duncmccl/ARMStrong/README.md

# ARMStrong
Microcontroller Learner board replacement for the BASYS MX3
