duncmccl/ARMStrong/GRBL/UDUINO-BOM.xlsx

Comment | Designator | Footprint | Manufacturer | Manufacturer Part Number
A000066 | A101 | Custom:ARDUINO_A000066 | Arduino | A000066
100n | C101, C102, C103, C104, C107, C108, C402, C502, C1202, C1302 | Capacitor_SMD:C_0805_2012Metric | Samsung Electro-Mechanics | CL21B104KCFNNNE
4u7 | C105, C106, C109, C401, C501 | Capacitor_SMD:C_0603_1608Metric | Samsung Electro-Mechanics | CL10A475KO8NNNC
10u | C201, C302, C601, C1201, C1301 | Capacitor_SMD:C_0603_1608Metric | Samsung Electro-Mechanics | CL10A106KP8NNNC
10n | C202, C301, C602 | Capacitor_SMD:C_0603_1608Metric | Samsung Electro-Mechanics | 0603B103K500NT
2u2 | C303 | Capacitor_SMD:C_0603_1608Metric | Samsung Electro-Mechanics | CL10A225KO8NNNC
1n | C403, C404, C503, C504 | Capacitor_SMD:C_0603_1608Metric | Samsung Electro-Mechanics | CL10B102KB8NNNC
22u | C1203, C1204, C1303, C1304 | Capacitor_SMD:C_0603_1608Metric | Samsung Electro-Mechanics | CL10A226MQ8NRNC
BAS70TW | D101 | Package_TO_SOT_SMD:SOT-363_SC-70-6 | Diodes Incorporated | BAS70TW
LTST-C190KRKT | D801, D802, D803, D804, D805, D806, D807, D808 | LEDC1608X35N | Lite-On | LTST-C190KRKT
AMC1602AR-B-Y6WFDY-SPI | DS1101 | Custom:AMC1602ARBY6WFDYSPI | Orient Display | AMC1602AR-B-Y6WFDY-SPI
Barrel_Jack | J101 | Connector_BarrelJack:BarrelJack_Horizontal | GlobTek, Inc. | G-1005B
Conn_01x02_Female | J102 | Connector_JST:JST_XH_B2B-XH-AM_1x02_P2.50mm_Vertical
PMOD1 | J103 | Connector_PinSocket_2.54mm:PinSocket_2x06_P2.54mm_Horizontal
Conn_01x03_Male | J104, J105 | Connector_PinHeader_2.54mm:PinHeader_1x03_P2.54mm_Vertical
Conn_01x04_Male | J106, J107 | Connector_PinHeader_2.54mm:PinHeader_1x04_P2.54mm_Vertical
Screw_Terminal_01x04 | J301 | TerminalBlock:TerminalBlock_bornier-4_P5.08mm
4u7 | L1201, L1301 | Inductor_SMD:L_1008_2520Metric | Samsung Electro-Mechanics | CIGW252010GL4R7MNE
LDQ-M516RI | LED901 | Custom:DIPS1524W50P254L5030H800Q12N | Lumex Opto/Components Inc. | 67-1449-ND
Speaker | LS401, LS501 | Custom:SPKR_AS01508MS-SC11-WP-R | PUI Audio, Inc. | AS01508MS-SC11-WP-R
CMM-4030D-261-I2S-TR | MK201, MK601 | Custom:MIC_CMM-4030D-261-I2S-TR | CUI Devices | CMM-4030D-261-I2S-TR
USB4105-GF-A | P1401 | Connector_USB:USB_C_Receptacle_Palconn_UTC16-G
SMMBT4403LT1G | Q901, Q902, Q903, Q904 | Package_TO_SOT_SMD:SOT-23 | onsemi | SMMBT4403LT1G
10k | R101, R701, R702, R703, R704, R705, R706, R707, R708, R1001, R1002, R1003, R1004, R1005 | Resistor_SMD:R_0603_1608Metric | UNI-ROYAL(Uniroyal Elec) | 0603WAF1002T5E
100 | R201, R601, R1101, R1102 | Resistor_SMD:R_0603_1608Metric | UNI-ROYAL(Uniroyal Elec) | 0603WAF1000T5E
220 | R801, R802, R803, R804, R805, R806, R807, R808, R905, R906, R907, R908, R909, R910, R911, R912 | Resistor_SMD:R_0603_1608Metric | UNI-ROYAL(Uniroyal Elec) | 0603WAF2200T5E
1k | R901, R902, R903, R904 | Resistor_SMD:R_0603_1608Metric | UNI-ROYAL(Uniroyal Elec) | 0603WAF1001T5E
5k1 | R1401, R1402 | Resistor_SMD:R_0603_1608Metric | UNI-ROYAL(Uniroyal Elec) | 0603WAF5101T5E
100k | RV101, RV1101 | Custom:TRIM_3352T-1-104LF | Bourns Inc. | 3352T-1-104LF
PTS636 SM43 SMTR LFS | S101, S102, S1002, S1003, S1004, S1005 | PTS636SM43SMTRLFS | C & K COMPONENTS | PTS636 SM43 SMTR LFS
EG1218 | S701, S702, S703, S704, S705, S706, S707, S708 | EG1218 | E-Switch | EG1218
PTS636_SM43_SMTR_LFS | S1001 | Custom:PTS636SM43SMTRLFS | C & K COMPONENTS | PTS636 SM43 SMTR LFS
STM32F072VBTx | U101 | Package_QFP:LQFP-100_14x14mm_P0.5mm | STMicroelectronics | STM32F072VBT6
DRV8833RTY | U301 | Package_DFN_QFN:Texas_S-PWQFN-N16_EP2.1x2.1mm | Texas Instruments | DRV8833RTYT
NAU8315YG | U401, U501 | Custom:QFN50P400X400X80-21N | Nuvoton Technology Corporation | NAU8315YG
AP63205WU | U1201 | Package_TO_SOT_SMD:TSOT-23-6 | Diodes Incorporated | AP63205WU-7
AP63203WU | U1301 | Package_TO_SOT_SMD:TSOT-23-6 | Diodes Incorporated | AP63203WU-7
