duncmccl/ARMStrong/(threads)

Thread 2 (2023-04-21):

Seven Segment Display Voltage

duncmccl, 2023-04-21:
The Seven Segment Display is intended to be driven with 5v, however the microcontroller uses 3v logic signals. Therefore an alternate design is needed, possibly using a level shifting circuit.

Thread 3 (2023-04-21):

I2S and SPI conflict

duncmccl, 2023-04-21:
I2S1 and SPI1 conflict in the microcontroller hardware. Only one can be used at a time, while the other must be substituted with a software alternative.

A redesign would omit the I2S interfaces, and instead use the ADC and DAC to drive the audio circuits.

Thread 4 (2023-04-21):

Schottky Diode

duncmccl, 2023-04-21:
At high current draw, the Schottky diode has a high resistance, dropping the output voltage by as much as two volts. An alternate part is needed.

Thread 5 (2023-04-21):

Serial Wire Debug pins mapping

duncmccl, 2023-04-21:
The Serial Wire Debug (SWD) pins are mapped to the same pins as the Motor controller. This makes it inconvenient to use the ST-Link device. The SWD pins should be remapped to the PMOD pins, or to debug dedicated pins.

Thread 6 (2023-04-21):

Power Regulators

duncmccl, 2023-04-21:
Current power regulators are buck converters that can drop the voltage to an appropriate level, however they are unable to boost it to needed levels. Need to pick a different part that can do so.
