duncmccl/ARMStrong/SevenSeg/LDQ-M516RI.pdf

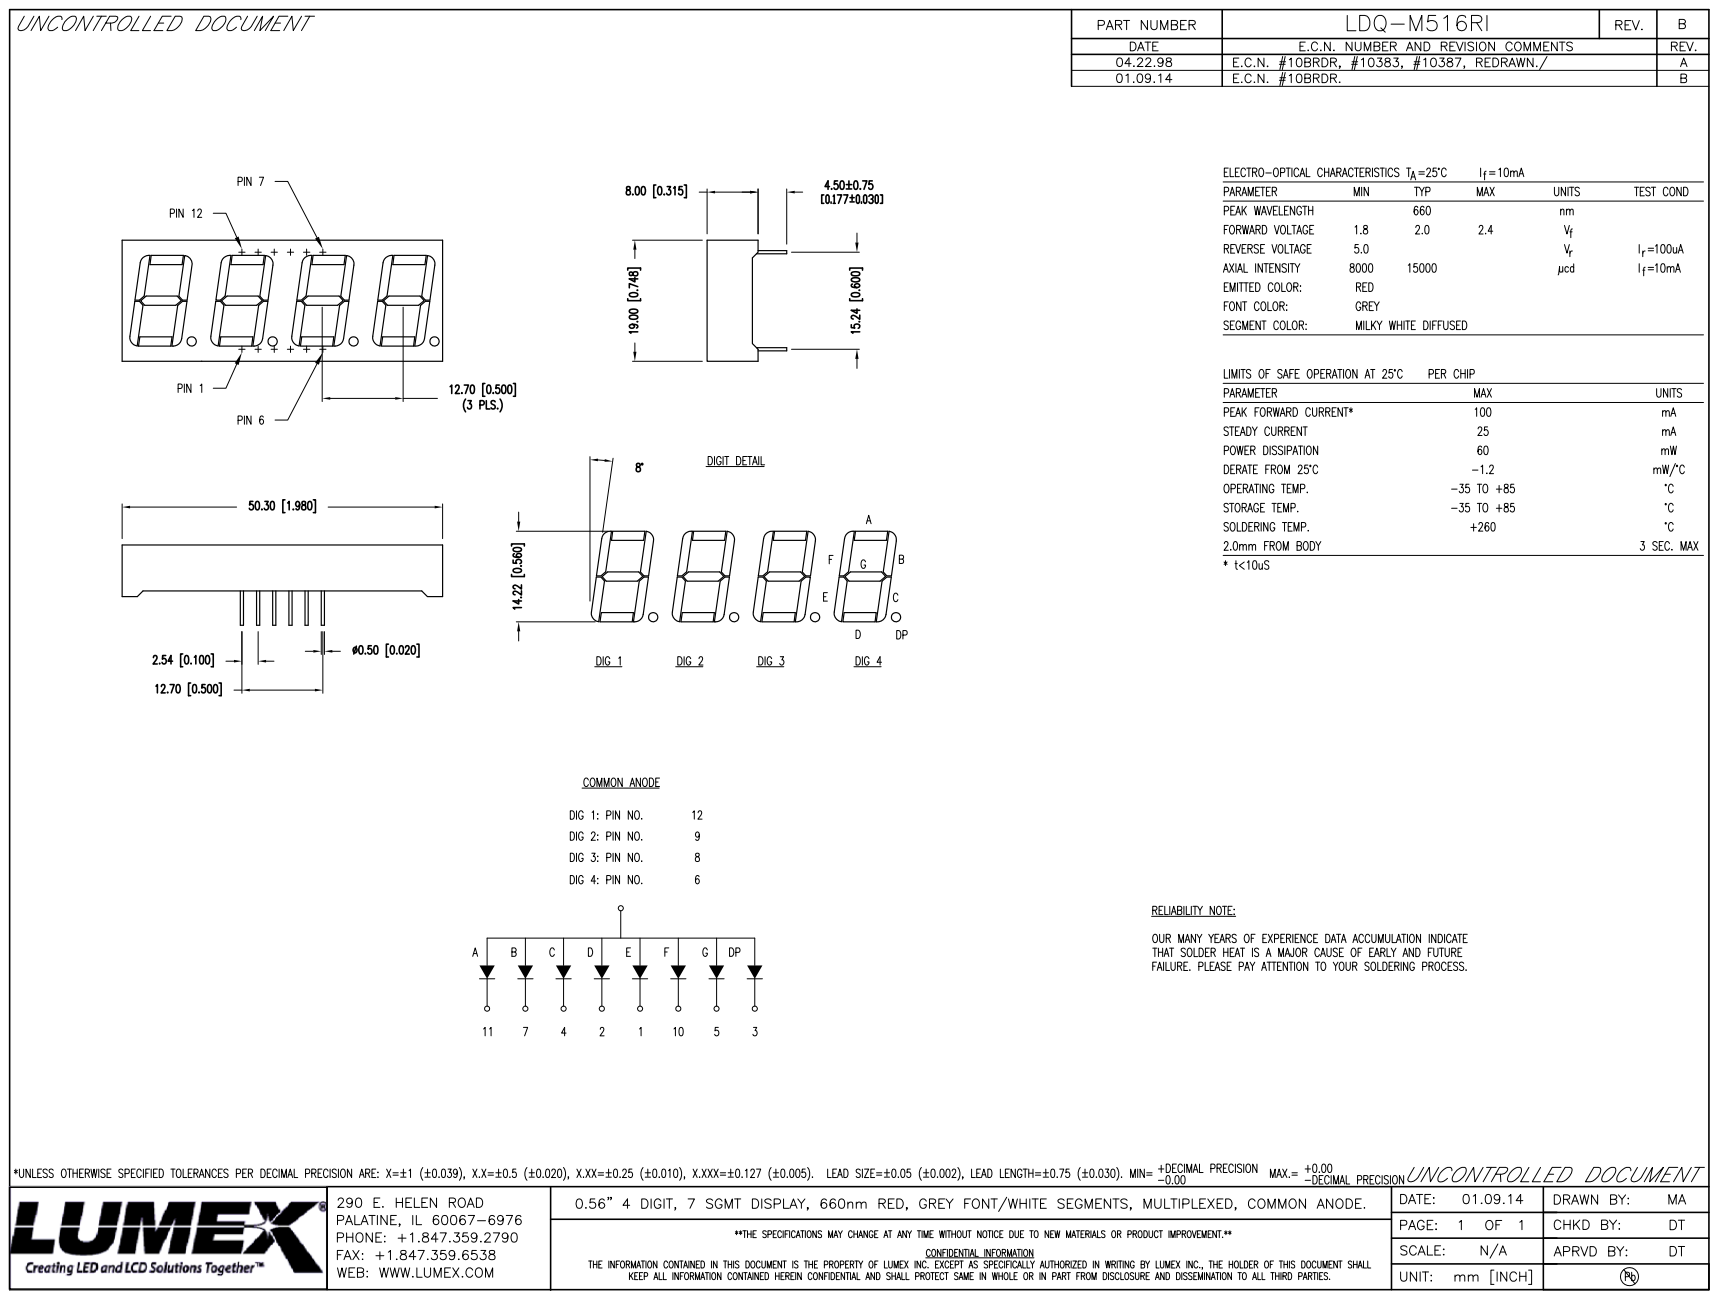
[picture p1: page 1]
