duncmccl/ARMStrong/UDuino.kicad_pcb

## KiCad design UDuino.kicad_pcb (2023-02-20)

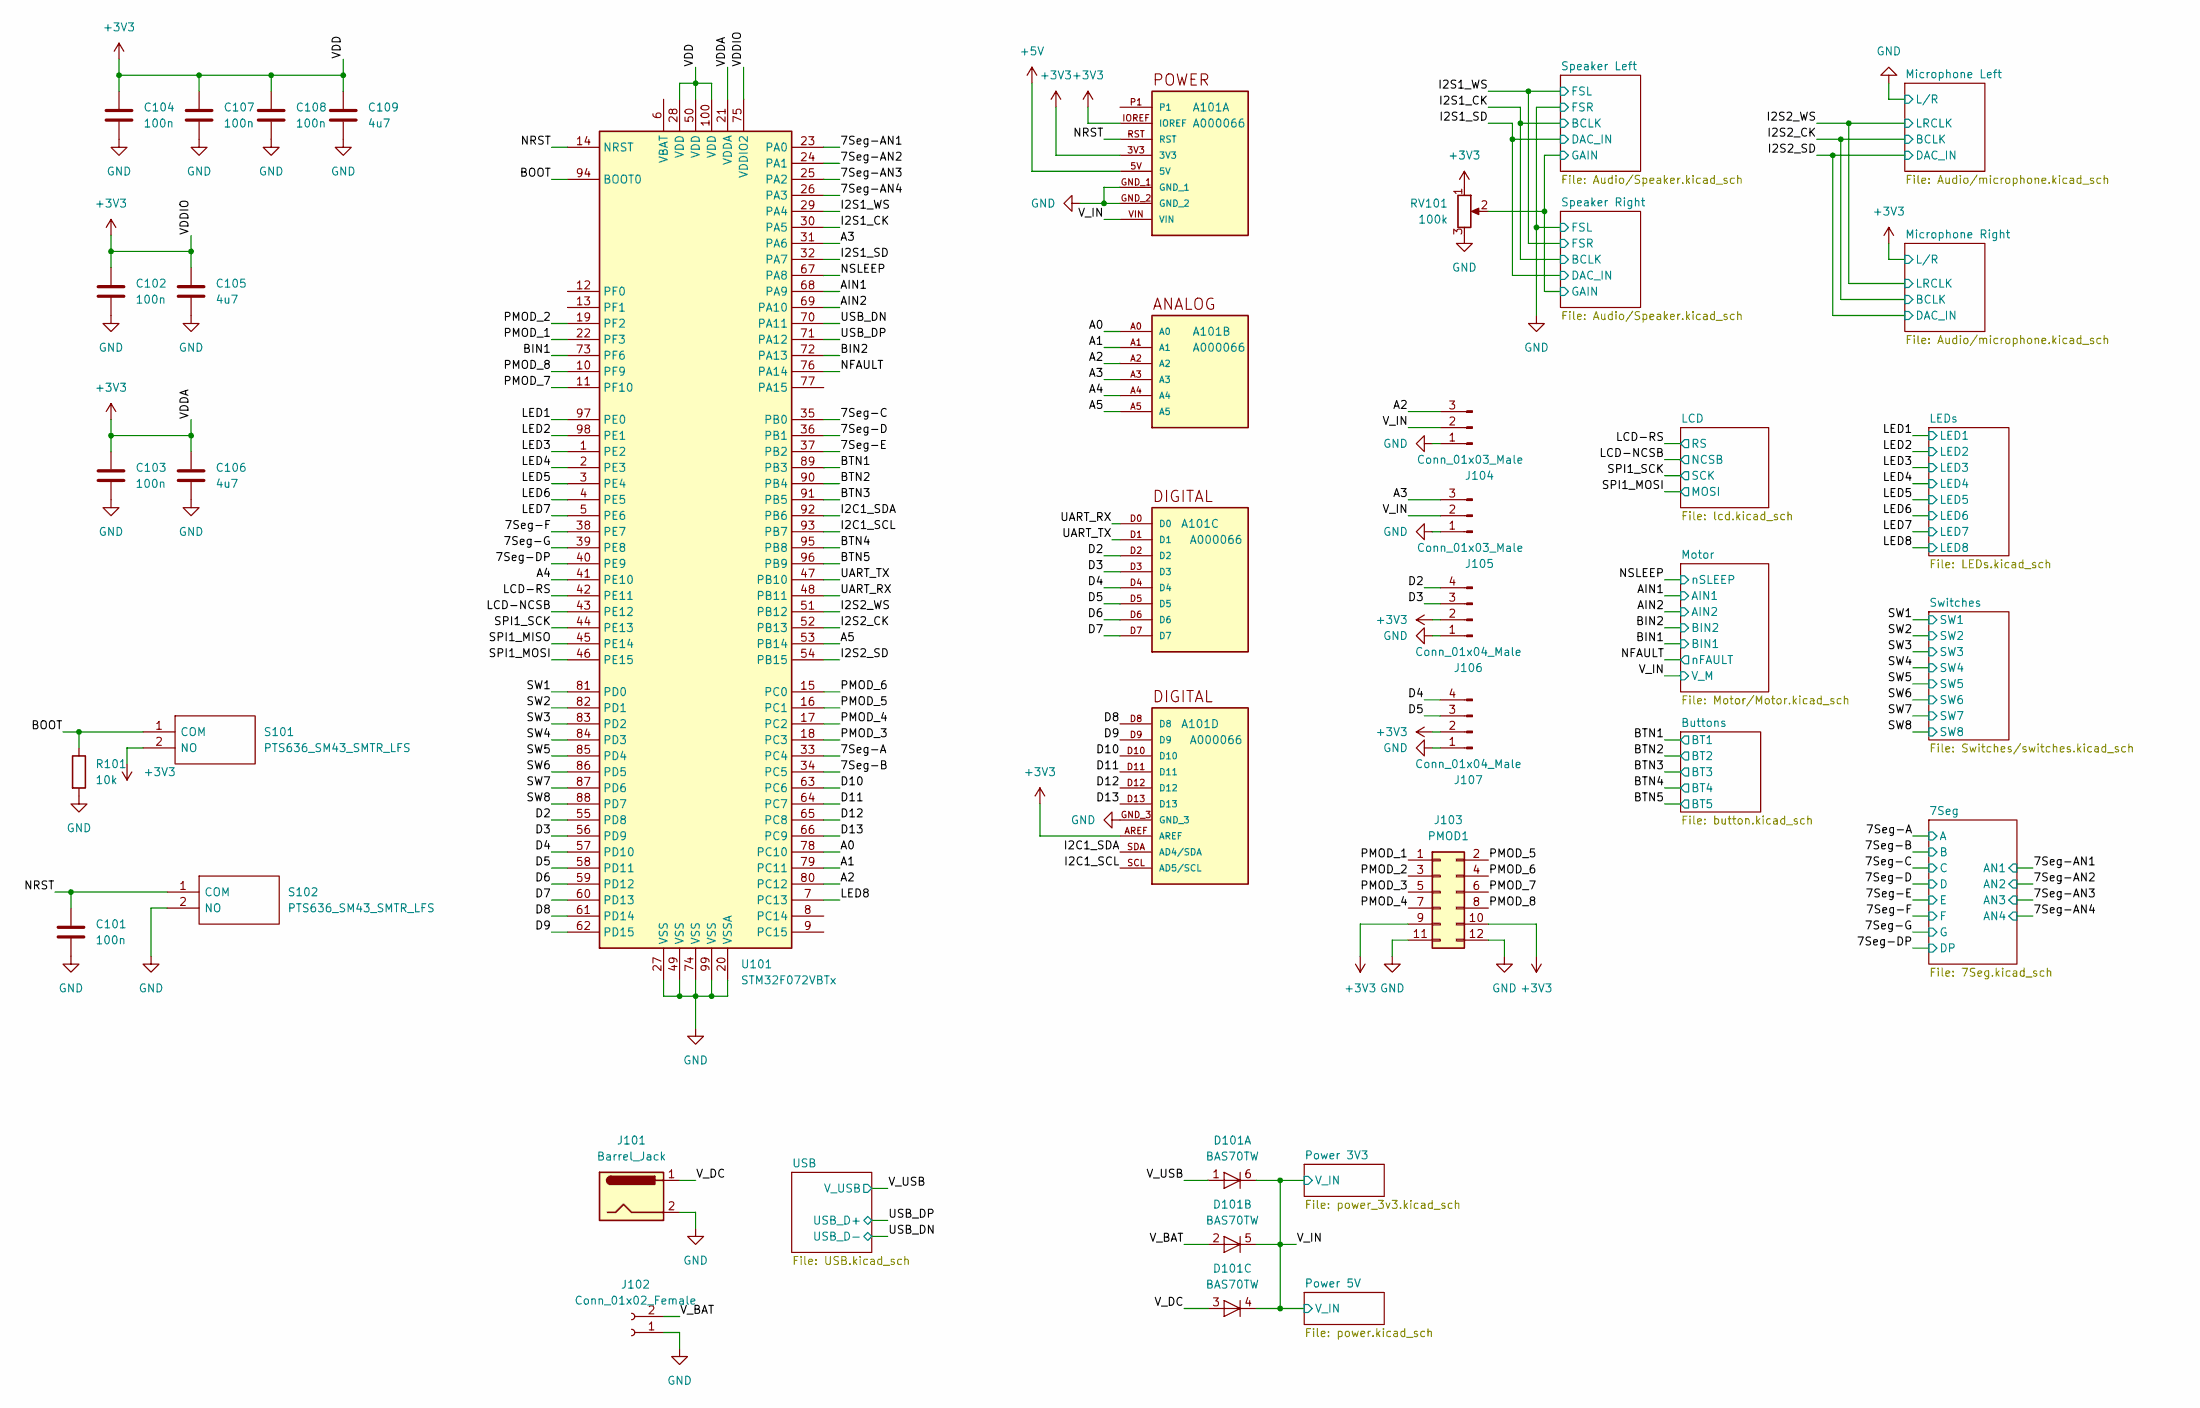
[picture p2: schematic UDuino.kicad_sch]

Parts:
A101: A000066; ARDUINO_A000066; Manufacturer_Part_Number A000066
C101, C102, C103, C104, C107, C108: 100n; C_0805_2012Metric; Manufacturer_Part_Number CL21B104KCFNNNE
C105, C106, C109: 4u7; C_0603_1608Metric; Manufacturer_Part_Number CL10A475KO8NNNC
D101: BAS70TW; SOT-363_SC-70-6; Manufacturer_Part_Number BAS70TW
J101: Barrel_Jack; BarrelJack_Horizontal; Manufacturer_Part_Number G-1005B
J102: Conn_01x02_Female; JST_XH_B2B-XH-AM_1x02_P2.50mm_Vertical
J103: PMOD1; PinSocket_2x06_P2.54mm_Horizontal
J104, J105: Conn_01x03_Male; PinHeader_1x03_P2.54mm_Vertical
J106, J107: Conn_01x04_Male; PinHeader_1x04_P2.54mm_Vertical
R101: 10k; R_0603_1608Metric; Manufacturer_Part_Number 0603WAF1002T5E
RV101: 100k; TRIM_3352T-1-104LF
S101, S102: PTS636_SM43_SMTR_LFS; PTS636SM43SMTRLFS; Mouser Part Number 611-PTS636SM43SMTRLF
U101: STM32F072VBTx; LQFP-100_14x14mm_P0.5mm

Connections:
+3V3: A101.3V3, A101.AREF, A101.IOREF, C102.2, C103.2, C104.2, C105.2, C106.2, C107.2, C108.2, C109.2, J103.9, J103.10, J106.2, J107.2, RV101.1, S101.2 (NO), U101.21 (VDDA), U101.28 (VDD), U101.50 (VDD), U101.75 (VDDIO2), U101.100 (VDD); also elsewhere on the board
+5V: A101.5V; also elsewhere on the board
/7Seg-A: U101.33 (PC4); also elsewhere on the board
/7Seg-AN1: U101.23 (PA0); also elsewhere on the board
/7Seg-AN2: U101.24 (PA1); also elsewhere on the board
/7Seg-AN3: U101.25 (PA2); also elsewhere on the board
/7Seg-AN4: U101.26 (PA3); also elsewhere on the board
/7Seg-B: U101.34 (PC5); also elsewhere on the board
/7Seg-C: U101.35 (PB0); also elsewhere on the board
/7Seg-D: U101.36 (PB1); also elsewhere on the board
/7Seg-DP: U101.40 (PE9); also elsewhere on the board
/7Seg-E: U101.37 (PB2); also elsewhere on the board
/7Seg-F: U101.38 (PE7); also elsewhere on the board
/7Seg-G: U101.39 (PE8); also elsewhere on the board
/A0: A101.A0, U101.78 (PC10)
/A1: A101.A1, U101.79 (PC11)
/A2: A101.A2, J104.3, U101.80 (PC12)
/A3: A101.A3, J105.3, U101.31 (PA6)
/A4: A101.A4, U101.41 (PE10)
/A5: A101.A5, U101.53 (PB14)
/AIN1: U101.68 (PA9); also elsewhere on the board
/AIN2: U101.69 (PA10); also elsewhere on the board
/BIN1: U101.73 (PF6); also elsewhere on the board
/BIN2: U101.72 (PA13); also elsewhere on the board
/BOOT: R101.1, S101.1 (COM), U101.94 (BOOT0)
/BTN1: U101.89 (PB3); also elsewhere on the board
/BTN2: U101.90 (PB4); also elsewhere on the board
/BTN3: U101.91 (PB5); also elsewhere on the board
/BTN4: U101.95 (PB8); also elsewhere on the board
/BTN5: U101.96 (PB9); also elsewhere on the board
/D2: A101.D2, J106.4, U101.55 (PD8)
/D3: A101.D3, J106.3, U101.56 (PD9)
/D4: A101.D4, J107.4, U101.57 (PD10)
/D5: A101.D5, J107.3, U101.58 (PD11)
/D6: A101.D6, U101.59 (PD12)
/D7: A101.D7, U101.60 (PD13)
/D8: A101.D8, U101.61 (PD14)
/D9: A101.D9, U101.62 (PD15)
/D10: A101.D10, U101.63 (PC6)
/D11: A101.D11, U101.64 (PC7)
/D12: A101.D12, U101.65 (PC8)
/D13: A101.D13, U101.66 (PC9)
/I2C1_SCL: A101.SCL (AD5/SCL), U101.93 (PB7)
/I2C1_SDA: A101.SDA (AD4/SDA), U101.92 (PB6)
/I2S1_CK: U101.30 (PA5); also elsewhere on the board
/I2S1_SD: U101.32 (PA7); also elsewhere on the board
/I2S1_WS: U101.29 (PA4); also elsewhere on the board
/I2S2_CK: U101.52 (PB13); also elsewhere on the board
/I2S2_SD: U101.54 (PB15); also elsewhere on the board
/I2S2_WS: U101.51 (PB12); also elsewhere on the board
/LCD-NCSB: U101.43 (PE12); also elsewhere on the board
/LCD-RS: U101.42 (PE11); also elsewhere on the board
/LED1: U101.97 (PE0); also elsewhere on the board
/LED2: U101.98 (PE1); also elsewhere on the board
/LED3: U101.1 (PE2); also elsewhere on the board
/LED4: U101.2 (PE3); also elsewhere on the board
/LED5: U101.3 (PE4); also elsewhere on the board
/LED6: U101.4 (PE5); also elsewhere on the board
/LED7: U101.5 (PE6); also elsewhere on the board
/LED8: U101.7 (PC13); also elsewhere on the board
/NFAULT: U101.76 (PA14); also elsewhere on the board
/NRST: A101.RST, C101.2, S102.1 (COM), U101.14 (NRST)
/NSLEEP: U101.67 (PA8); also elsewhere on the board
/PMOD_1: J103.1, U101.22 (PF3)
/PMOD_2: J103.3, U101.19 (PF2)
/PMOD_3: J103.5, U101.18 (PC3)
/PMOD_4: J103.7, U101.17 (PC2)
/PMOD_5: J103.2, U101.16 (PC1)
/PMOD_6: J103.4, U101.15 (PC0)
/PMOD_7: J103.6, U101.11 (PF10)
/PMOD_8: J103.8, U101.10 (PF9)
/SPI1_MISO: U101.45 (PE14)
/SPI1_MOSI: U101.46 (PE15); also elsewhere on the board
/SPI1_SCK: U101.44 (PE13); also elsewhere on the board
/SW1: U101.81 (PD0); also elsewhere on the board
/SW2: U101.82 (PD1); also elsewhere on the board
/SW3: U101.83 (PD2); also elsewhere on the board
/SW4: U101.84 (PD3); also elsewhere on the board
/SW5: U101.85 (PD4); also elsewhere on the board
/SW6: U101.86 (PD5); also elsewhere on the board
/SW7: U101.87 (PD6); also elsewhere on the board
/SW8: U101.88 (PD7); also elsewhere on the board
/Speaker Left/GAIN: RV101.2; also elsewhere on the board
/UART_RX: A101.D0, U101.48 (PB11)
/UART_TX: A101.D1, U101.47 (PB10)
/USB_DN: U101.70 (PA11); also elsewhere on the board
/USB_DP: U101.71 (PA12); also elsewhere on the board
/V_BAT: D101.2 (A), J102.2
/V_DC: D101.3 (A), J101.1
/V_IN: A101.VIN, D101.4 (K), D101.5 (K), D101.6 (K), J104.2, J105.2; also elsewhere on the board
/V_USB: D101.1 (A); also elsewhere on the board
GND: A101.GND_1, A101.GND_2, A101.GND_3, C101.1, C102.1, C103.1, C104.1, C105.1, C106.1, C107.1, C108.1, C109.1, J101.2, J102.1, J103.11, J103.12, J104.1, J105.1, J106.1, J107.1, R101.2, RV101.3, S102.2 (NO), U101.20 (VSSA), U101.27 (VSS), U101.49 (VSS), U101.74 (VSS), U101.99 (VSS); also elsewhere on the board

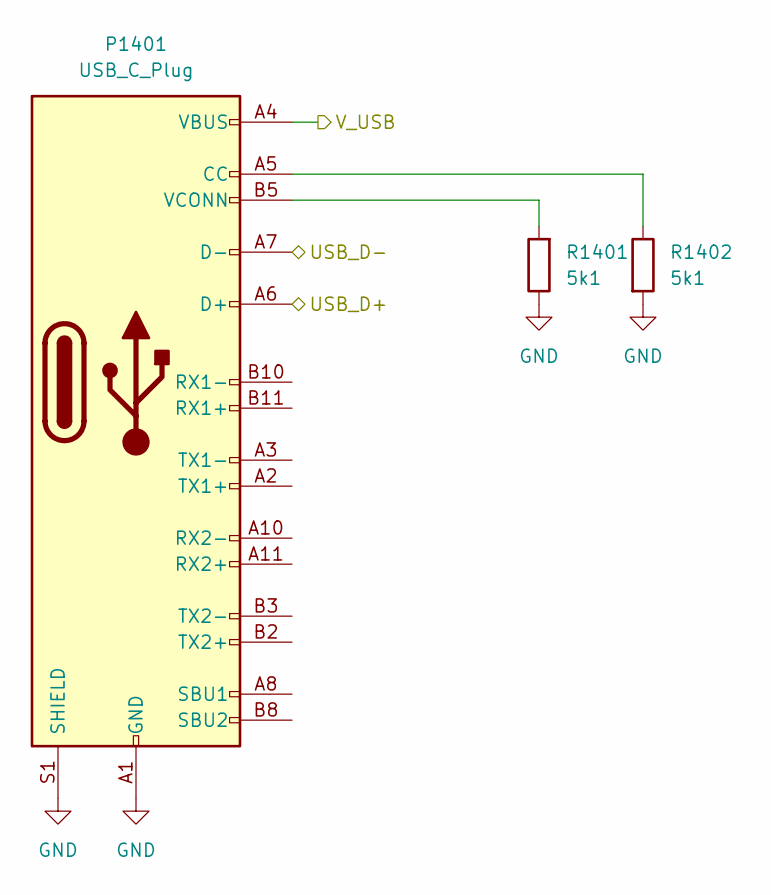
[picture p3: schematic USB.kicad_sch]

Parts:
P1401: USB_C_Plug; USB_C_Receptacle_Palconn_UTC16-G
R1401, R1402: 5k1; R_0603_1608Metric; Manufacturer_Part_Number 0603WAF5101T5E

Connections:
/USB_DN: P1401.A7 (D-); also elsewhere on the board
/USB_DP: P1401.A6 (D+); also elsewhere on the board
/V_USB: P1401.A4 (VBUS), P1401.A9 (VBUS), P1401.B4 (VBUS), P1401.B9 (VBUS); also elsewhere on the board
GND: P1401.A1 (GND), P1401.A12 (GND), P1401.B1 (GND), P1401.B12 (GND), P1401.S1 (SHIELD), R1401.1, R1402.2; also elsewhere on the board
unnamed: P1401.A5 (CC), R1402.1
unnamed: P1401.B5 (VCONN), R1401.2

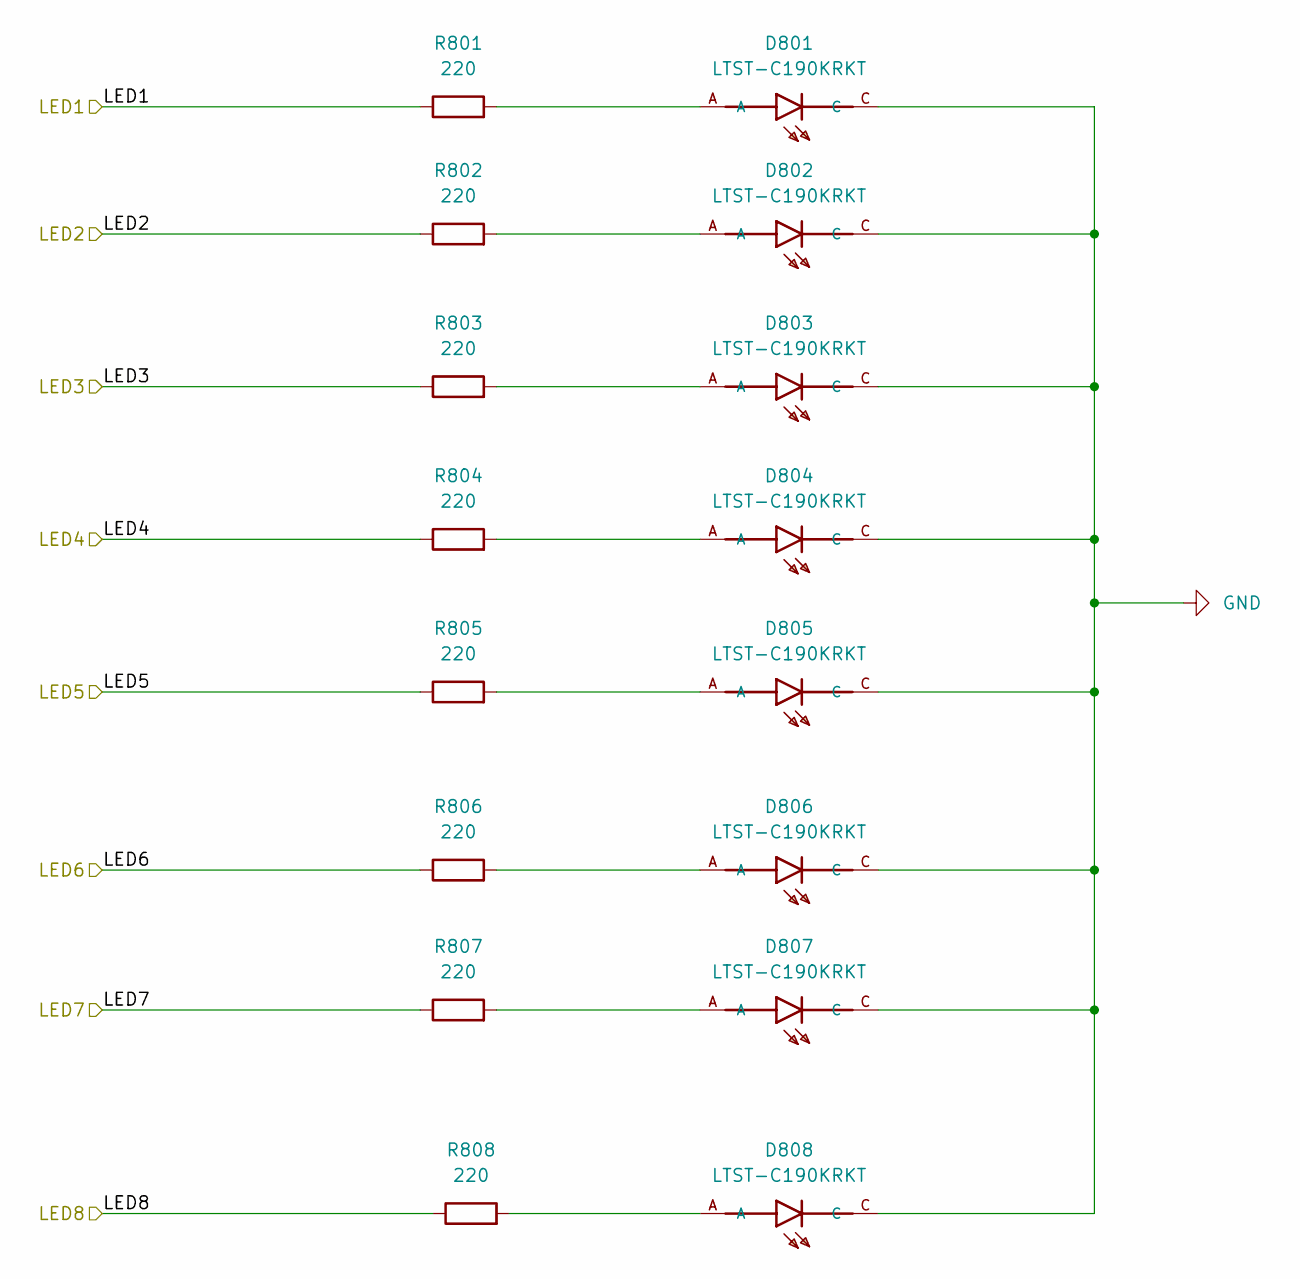
[picture p4: schematic LEDs.kicad_sch]

Parts:
D801, D802, D803, D804, D805, D806, D807, D808: LTST-C190KRKT; LEDC1608X35N; Manufacturer_Part_Number LTST-C190KRKT
R801, R802, R803, R804, R805, R806, R807, R808: 220; R_0603_1608Metric; Manufacturer_Part_Number 0603WAF2200T5E

Connections:
/LED1: R801.1; also elsewhere on the board
/LED2: R802.1; also elsewhere on the board
/LED3: R803.1; also elsewhere on the board
/LED4: R804.1; also elsewhere on the board
/LED5: R805.1; also elsewhere on the board
/LED6: R806.1; also elsewhere on the board
/LED7: R807.1; also elsewhere on the board
/LED8: R808.1; also elsewhere on the board
GND: D801.C, D802.C, D803.C, D804.C, D805.C, D806.C, D807.C, D808.C; also elsewhere on the board
unnamed: D801.A, R801.2
unnamed: D802.A, R802.2
unnamed: D803.A, R803.2
unnamed: D804.A, R804.2
unnamed: D805.A, R805.2
unnamed: D806.A, R806.2
unnamed: D807.A, R807.2
unnamed: D808.A, R808.2

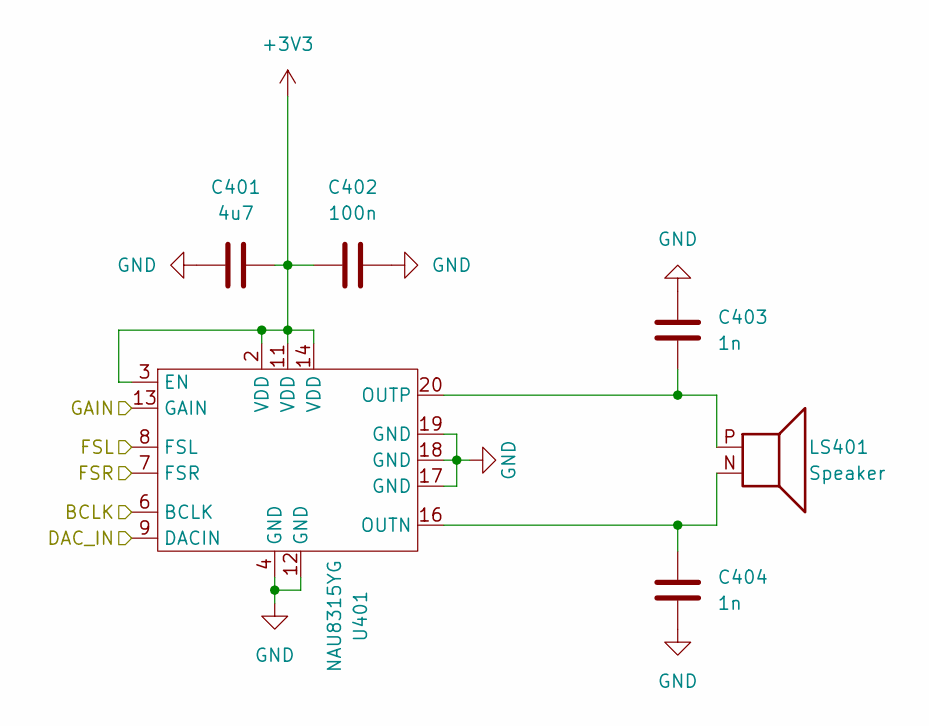
[picture p5: schematic Speaker.kicad_sch]

Parts:
C401: 4u7; C_0603_1608Metric; Manufacturer_Part_Number CL10A475KO8NNNC
C402: 100n; C_0805_2012Metric; Manufacturer_Part_Number CL21B104KCFNNNE
C403, C404: 1n; C_0603_1608Metric; Manufacturer_Part_Number CL10B102KB8NNNC
LS401: Speaker; SPKR_AS01508MS-SC11-WP-R
U401: NAU8315YG; QFN50P400X400X80-21N

Connections:
+3V3: C401.2, C402.1, U401.2 (VDD), U401.3 (EN), U401.11 (VDD), U401.14 (VDD); also elsewhere on the board
/I2S1_CK: U401.6 (BCLK); also elsewhere on the board
/I2S1_SD: U401.9 (DACIN); also elsewhere on the board
/I2S1_WS: U401.8 (FSL); also elsewhere on the board
/Speaker Left/GAIN: U401.13 (GAIN); also elsewhere on the board
GND: C401.1, C402.2, C403.1, C404.2, U401.4 (GND), U401.7 (FSR), U401.12 (GND), U401.17 (GND), U401.18 (GND), U401.19 (GND); also elsewhere on the board
unnamed: C403.2, LS401.P (1), U401.20 (OUTP)
unnamed: C404.1, LS401.N (2), U401.16 (OUTN)

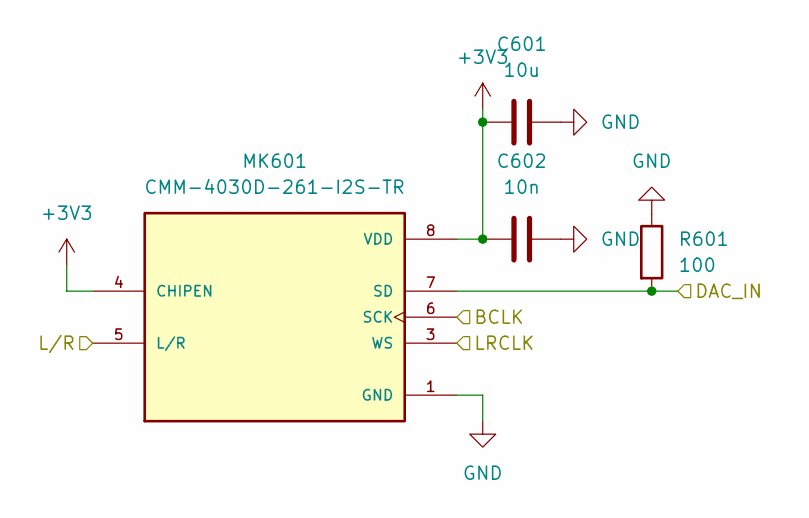
[picture p6: schematic microphone.kicad_sch]

Parts:
C601: 10u; C_0603_1608Metric; Manufacturer_Part_Number CL10A106KP8NNNC
C602: 10n; C_0603_1608Metric; Manufacturer_Part_Number 0603B103K500NT
MK601: CMM-4030D-261-I2S-TR; MIC_CMM-4030D-261-I2S-TR; PARTREV 1.0
R601: 100; R_0603_1608Metric; Manufacturer_Part_Number 0603WAF1000T5E

Connections:
+3V3: C601.1, C602.2, MK601.4 (CHIPEN), MK601.8 (VDD); also elsewhere on the board
/I2S2_CK: MK601.6 (SCK); also elsewhere on the board
/I2S2_SD: MK601.7 (SD), R601.2; also elsewhere on the board
/I2S2_WS: MK601.3 (WS); also elsewhere on the board
GND: C601.2, C602.1, MK601.1 (GND), MK601.5 (L/R), R601.1; also elsewhere on the board

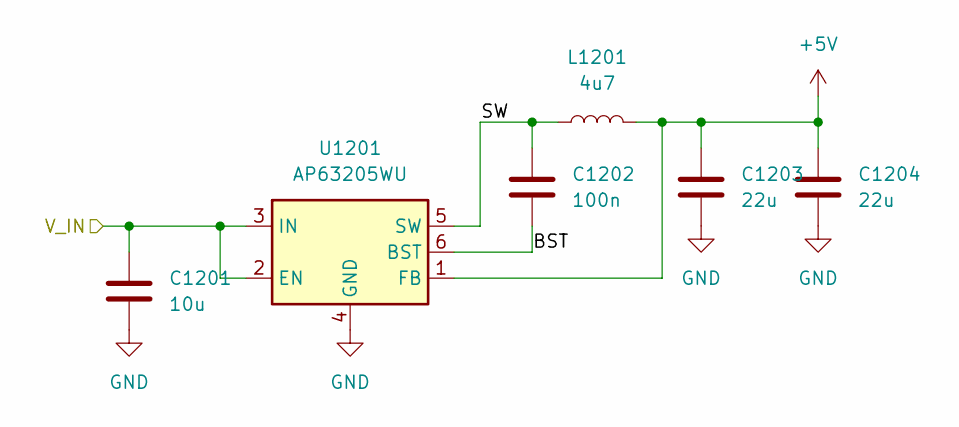
[picture p7: schematic power.kicad_sch]

Parts:
C1201: 10u; C_0603_1608Metric; Manufacturer_Part_Number CL10A106KP8NNNC
C1202: 100n; C_0805_2012Metric; Manufacturer_Part_Number CL21B104KCFNNNE
C1203, C1204: 22u; C_0603_1608Metric; Manufacturer_Part_Number CL10A226MQ8NRNC
L1201: 4u7; L_1008_2520Metric; Manufacturer_Part_Number CIGW252010GL4R7MNE
U1201: AP63205WU; TSOT-23-6

Connections:
+5V: C1203.1, C1204.1, L1201.2, U1201.1 (FB); also elsewhere on the board
/Power 5V/BST: C1202.2, U1201.6 (BST)
/Power 5V/SW: C1202.1, L1201.1, U1201.5 (SW)
/V_IN: C1201.1, U1201.2 (EN), U1201.3 (IN); also elsewhere on the board
GND: C1201.2, C1203.2, C1204.2, U1201.4 (GND); also elsewhere on the board

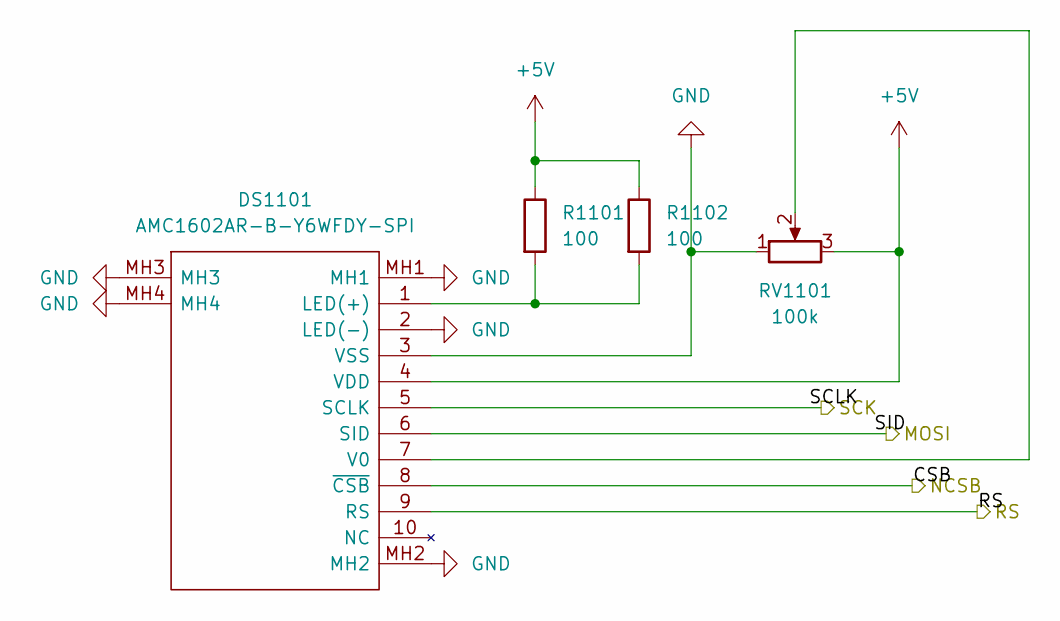
[picture p8: schematic lcd.kicad_sch]

Parts:
DS1101: AMC1602AR-B-Y6WFDY-SPI; AMC1602ARBY6WFDYSPI; Manufacturer_Part_Number AMC1602AR-B-Y6WFDY-SPI
R1101, R1102: 100; R_0603_1608Metric; Manufacturer_Part_Number 0603WAF1000T5E
RV1101: 100k; TRIM_3352T-1-104LF

Connections:
+5V: DS1101.4 (VDD), R1101.1, R1102.1, RV1101.3; also elsewhere on the board
/LCD-NCSB: DS1101.8 (~CSB); also elsewhere on the board
/LCD-RS: DS1101.9 (RS); also elsewhere on the board
/SPI1_MOSI: DS1101.6 (SID); also elsewhere on the board
/SPI1_SCK: DS1101.5 (SCLK); also elsewhere on the board
GND: DS1101.2 (LED(-)), DS1101.3 (VSS), DS1101.MH1, DS1101.MH2, DS1101.MH3, DS1101.MH4, RV1101.1; also elsewhere on the board
unnamed: DS1101.1 (LED(+)), R1101.2, R1102.2
unnamed: DS1101.7 (V0), RV1101.2

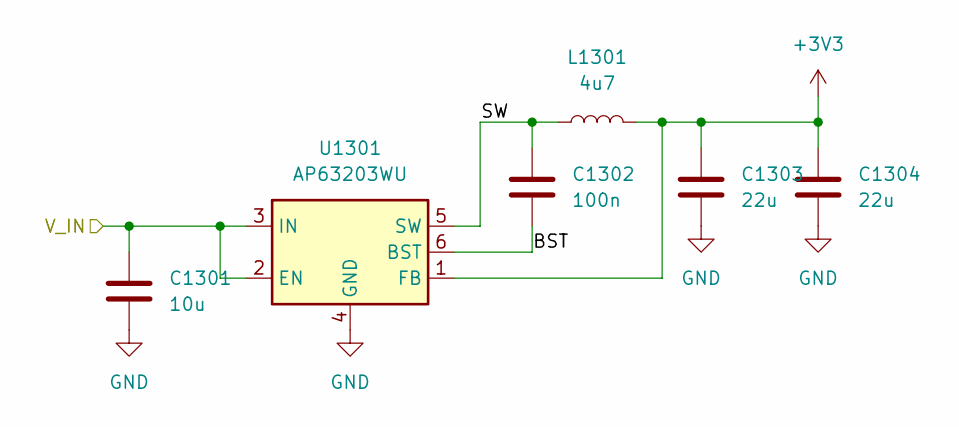
[picture p9: schematic power_3v3.kicad_sch]

Parts:
C1301: 10u; C_0603_1608Metric; Manufacturer_Part_Number CL10A106KP8NNNC
C1302: 100n; C_0805_2012Metric; Manufacturer_Part_Number CL21B104KCFNNNE
C1303, C1304: 22u; C_0603_1608Metric; Manufacturer_Part_Number CL10A226MQ8NRNC
L1301: 4u7; L_1008_2520Metric; Manufacturer_Part_Number CIGW252010GL4R7MNE
U1301: AP63203WU; TSOT-23-6

Connections:
+3V3: C1303.1, C1304.1, L1301.2, U1301.1 (FB); also elsewhere on the board
/Power 3V3/BST: C1302.2, U1301.6 (BST)
/Power 3V3/SW: C1302.1, L1301.1, U1301.5 (SW)
/V_IN: C1301.1, U1301.2 (EN), U1301.3 (IN); also elsewhere on the board
GND: C1301.2, C1303.2, C1304.2, U1301.4 (GND); also elsewhere on the board

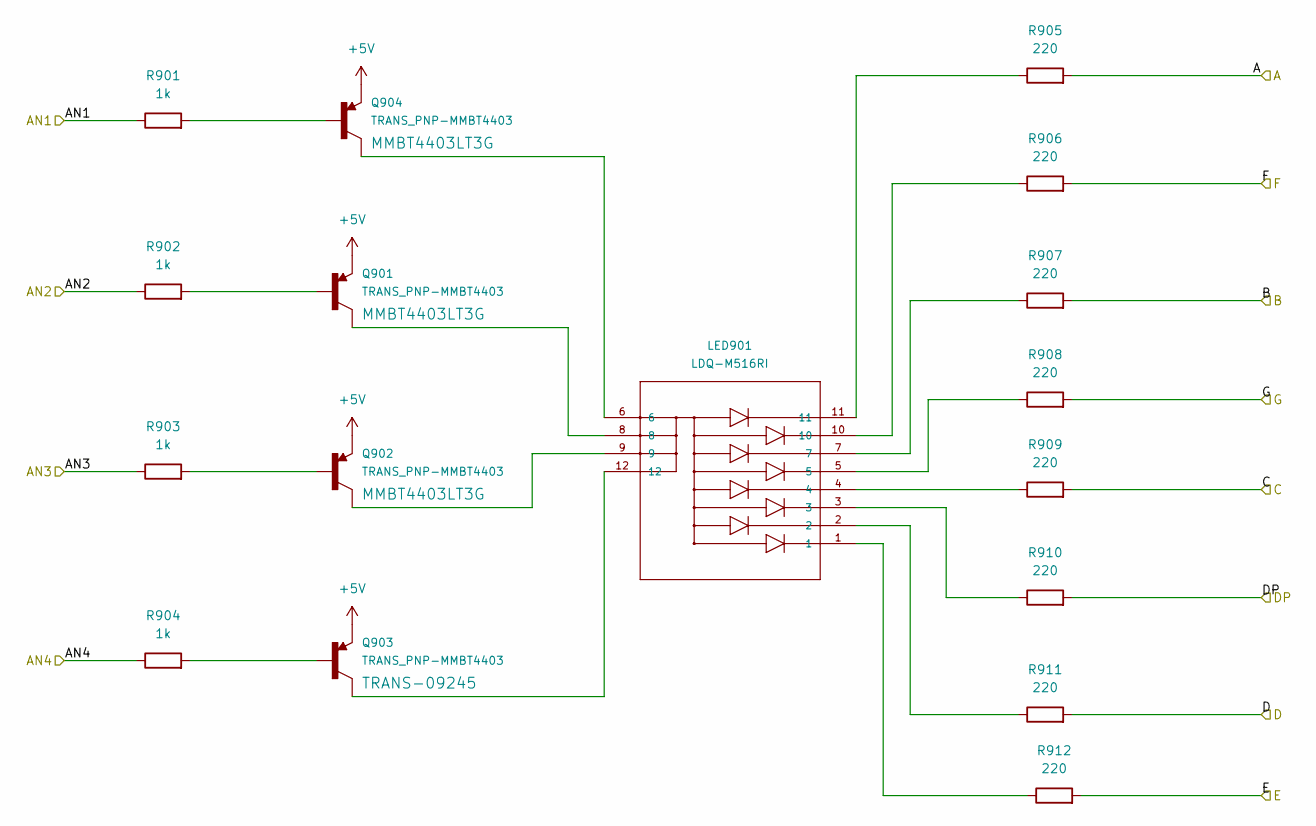
[picture p10: schematic 7Seg.kicad_sch]

Parts:
LED901: LDQ-M516RI; DIPS1524W50P254L5030H800Q12N
Q901, Q902, Q903, Q904: TRANS_PNP-MMBT4403; SOT-23
R901, R902, R903, R904: 1k; R_0603_1608Metric; Manufacturer_Part_Number 0603WAF1001T5E
R905, R906, R907, R908, R909, R910, R911, R912: 220; R_0603_1608Metric; Manufacturer_Part_Number 0603WAF2200T5E

Connections:
+5V: Q901.2 (E), Q902.2 (E), Q903.2 (E), Q904.2 (E); also elsewhere on the board
/7Seg-A: R905.2; also elsewhere on the board
/7Seg-AN1: R901.1; also elsewhere on the board
/7Seg-AN2: R902.1; also elsewhere on the board
/7Seg-AN3: R903.1; also elsewhere on the board
/7Seg-AN4: R904.1; also elsewhere on the board
/7Seg-B: R907.2; also elsewhere on the board
/7Seg-C: R909.2; also elsewhere on the board
/7Seg-D: R911.2; also elsewhere on the board
/7Seg-DP: R910.2; also elsewhere on the board
/7Seg-E: R912.2; also elsewhere on the board
/7Seg-F: R906.2; also elsewhere on the board
/7Seg-G: R908.2; also elsewhere on the board
unnamed: LED901.1, R912.1
unnamed: LED901.2, R911.1
unnamed: LED901.3, R910.1
unnamed: LED901.4, R909.1
unnamed: LED901.5, R908.1
unnamed: LED901.6, Q904.3 (C)
unnamed: LED901.7, R907.1
unnamed: LED901.8, Q901.3 (C)
unnamed: LED901.9, Q902.3 (C)
unnamed: LED901.10, R906.1
unnamed: LED901.11, R905.1
unnamed: LED901.12, Q903.3 (C)
unnamed: Q901.1 (B), R902.2
unnamed: Q902.1 (B), R903.2
unnamed: Q903.1 (B), R904.2
unnamed: Q904.1 (B), R901.2

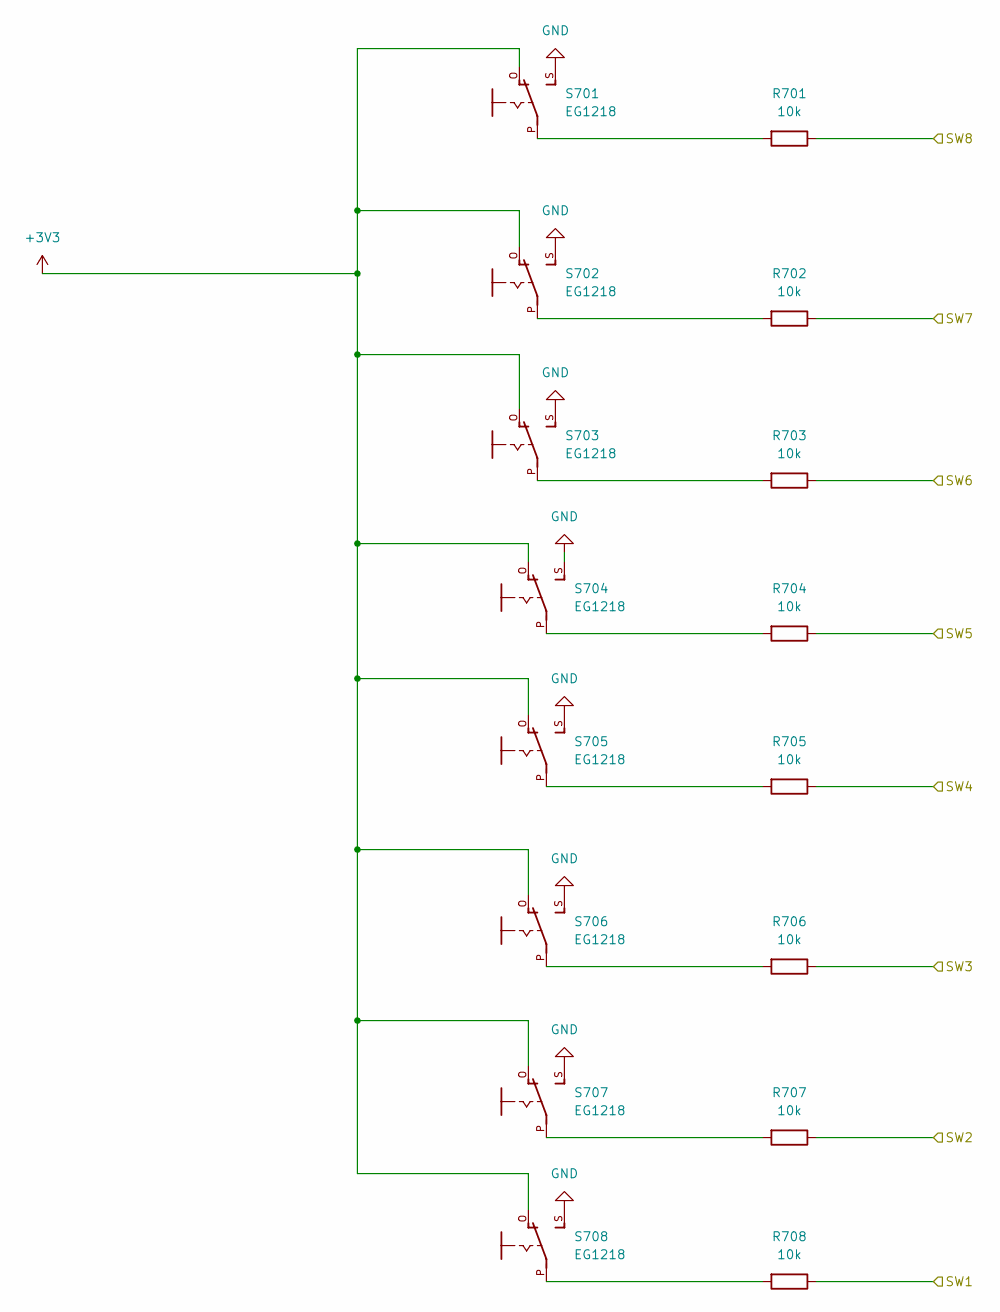
[picture p11: schematic switches.kicad_sch]

Parts:
R701, R702, R703, R704, R705, R706, R707, R708: 10k; R_0603_1608Metric; Manufacturer_Part_Number 0603WAF1002T5E
S701, S702, S703, S704, S705, S706, S707, S708: EG1218

Connections:
+3V3: S701.O, S702.O, S703.O, S704.O, S705.O, S706.O, S707.O, S708.O; also elsewhere on the board
/SW1: R708.1; also elsewhere on the board
/SW2: R707.1; also elsewhere on the board
/SW3: R706.1; also elsewhere on the board
/SW4: R705.1; also elsewhere on the board
/SW5: R704.1; also elsewhere on the board
/SW6: R703.1; also elsewhere on the board
/SW7: R702.1; also elsewhere on the board
/SW8: R701.1; also elsewhere on the board
GND: S701.S, S702.S, S703.S, S704.S, S705.S, S706.S, S707.S, S708.S; also elsewhere on the board
unnamed: R701.2, S701.P
unnamed: R702.2, S702.P
unnamed: R703.2, S703.P
unnamed: R704.2, S704.P
unnamed: R705.2, S705.P
unnamed: R706.2, S706.P
unnamed: R707.2, S707.P
unnamed: R708.2, S708.P

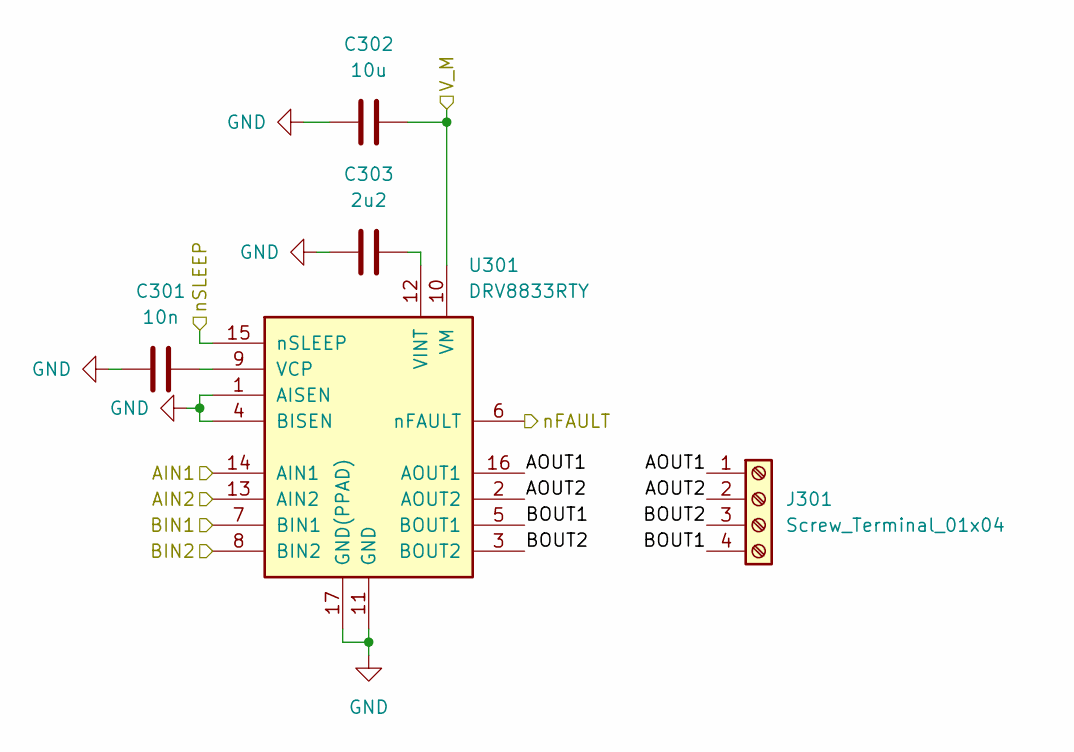
[picture p12: schematic Motor.kicad_sch]

Parts:
C301: 10n; C_0603_1608Metric; Manufacturer_Part_Number 0603B103K500NT
C302: 10u; C_0603_1608Metric; Manufacturer_Part_Number CL10A106KP8NNNC
C303: 2u2; C_0603_1608Metric; Manufacturer_Part_Number CL10A225KO8NNNC
J301: Screw_Terminal_01x04; TerminalBlock_bornier-4_P5.08mm
U301: DRV8833RTY; Texas_S-PWQFN-N16_EP2.1x2.1mm

Connections:
/AIN1: U301.14 (AIN1); also elsewhere on the board
/AIN2: U301.13 (AIN2); also elsewhere on the board
/BIN1: U301.7 (BIN1); also elsewhere on the board
/BIN2: U301.8 (BIN2); also elsewhere on the board
/Motor/AOUT1: J301.1, U301.16 (AOUT1)
/Motor/AOUT2: J301.2, U301.2 (AOUT2)
/Motor/BOUT1: J301.4, U301.5 (BOUT1)
/Motor/BOUT2: J301.3, U301.3 (BOUT2)
/NFAULT: U301.6 (nFAULT); also elsewhere on the board
/NSLEEP: U301.15 (nSLEEP); also elsewhere on the board
/V_IN: C302.2, U301.10 (VM); also elsewhere on the board
GND: C301.1, C302.1, C303.1, U301.1 (AISEN), U301.4 (BISEN), U301.11 (GND), U301.17 (GND(PPAD)); also elsewhere on the board
unnamed: C301.2, U301.9 (VCP)
unnamed: C303.2, U301.12 (VINT)

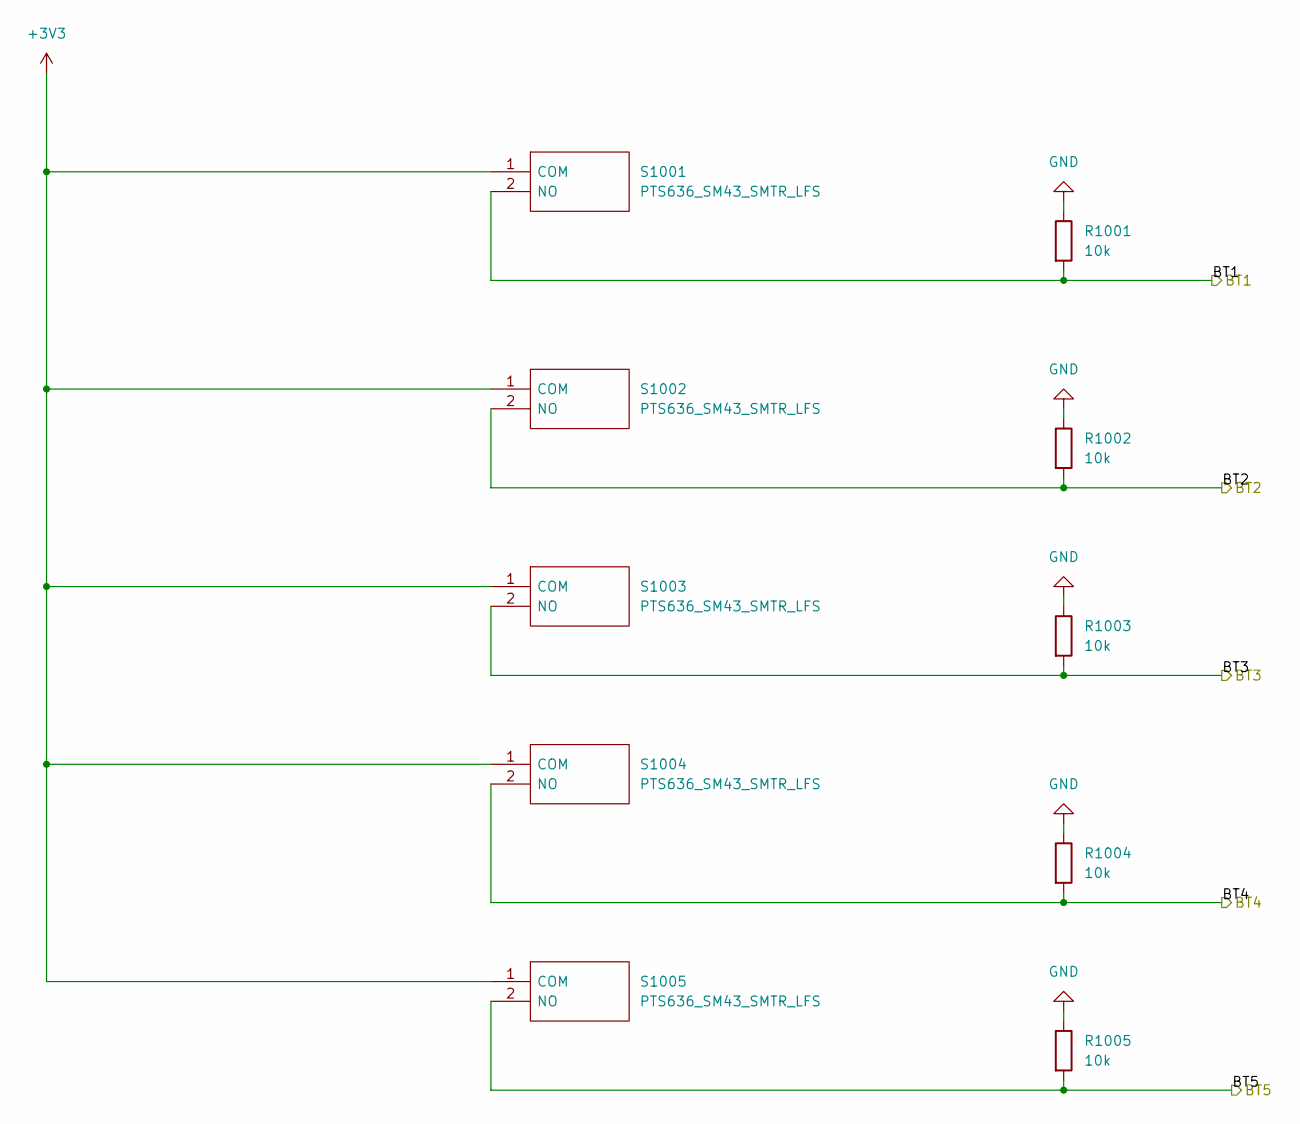
[picture p13: schematic button.kicad_sch]

Parts:
R1001, R1002, R1003, R1004, R1005: 10k; R_0603_1608Metric; Manufacturer_Part_Number 0603WAF1002T5E
S1001, S1002, S1003, S1004, S1005: PTS636_SM43_SMTR_LFS; PTS636SM43SMTRLFS; Mouser Part Number 611-PTS636SM43SMTRLF

Connections:
+3V3: S1001.1 (COM), S1002.1 (COM), S1003.1 (COM), S1004.1 (COM), S1005.1 (COM); also elsewhere on the board
/BTN1: R1001.2, S1001.2 (NO); also elsewhere on the board
/BTN2: R1002.2, S1002.2 (NO); also elsewhere on the board
/BTN3: R1003.2, S1003.2 (NO); also elsewhere on the board
/BTN4: R1004.2, S1004.2 (NO); also elsewhere on the board
/BTN5: R1005.2, S1005.2 (NO); also elsewhere on the board
GND: R1001.1, R1002.1, R1003.1, R1004.1, R1005.1; also elsewhere on the board
