duncmccl/ARMStrong/UDuino.kicad_pcb

## KiCad design UDuino.kicad_pcb (continued)

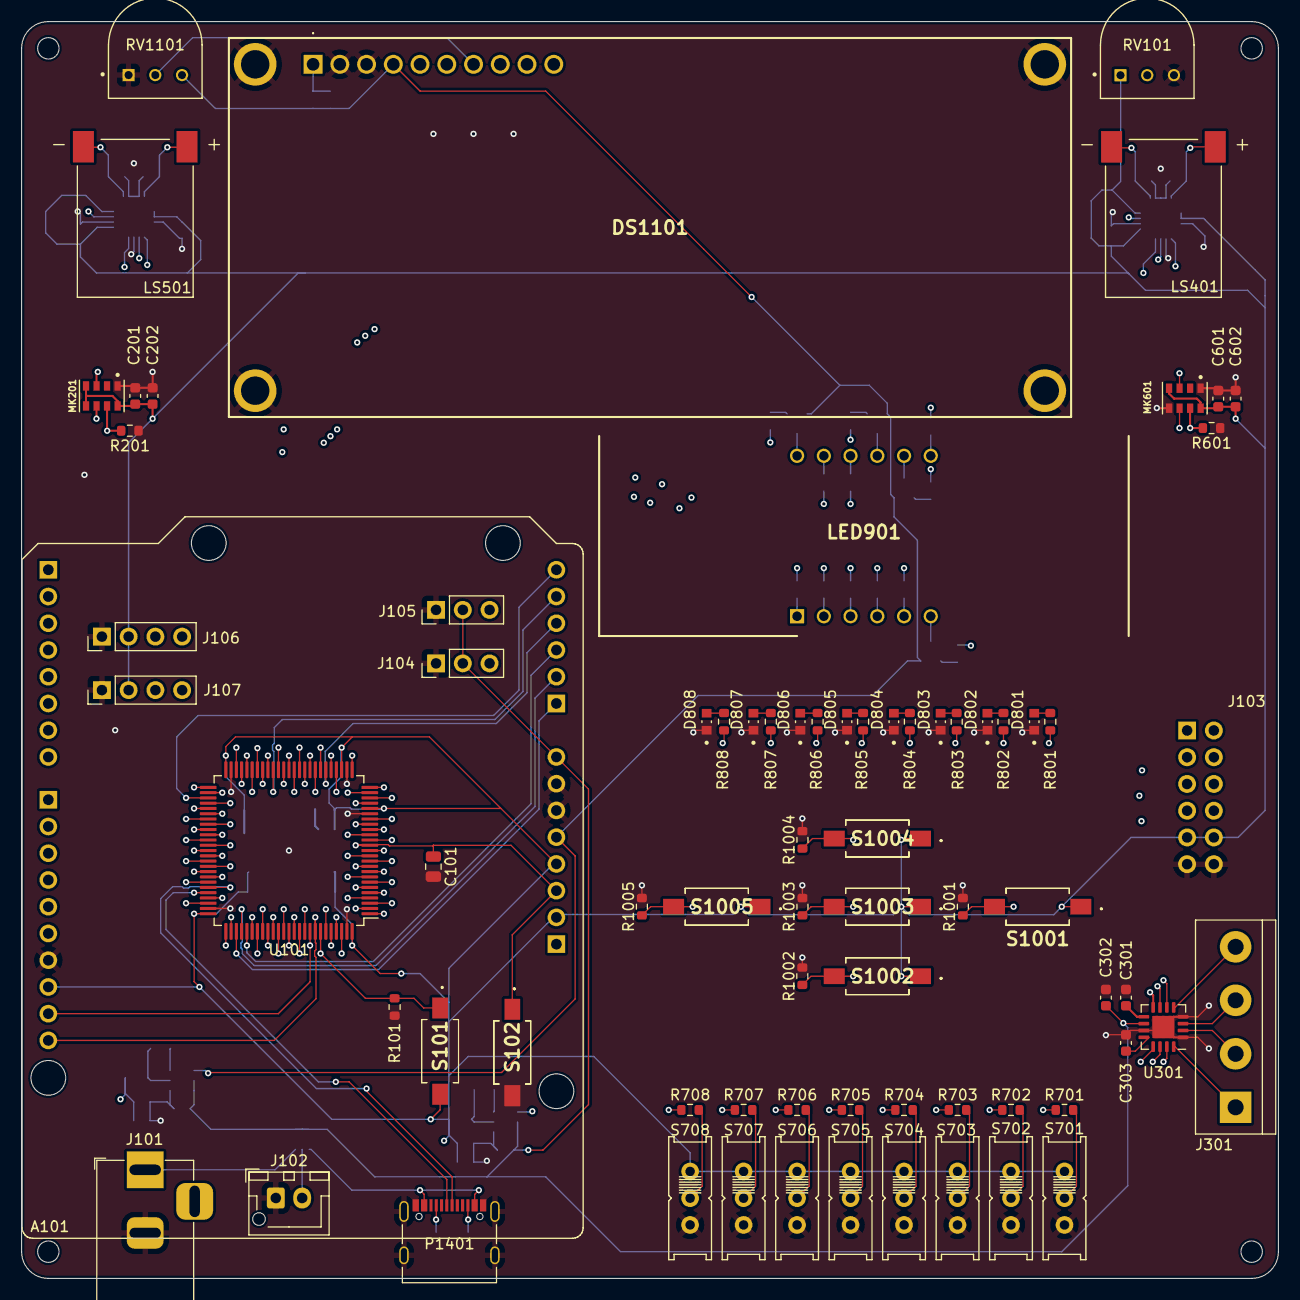
[picture p14: board UDuino.kicad_pcb from above]

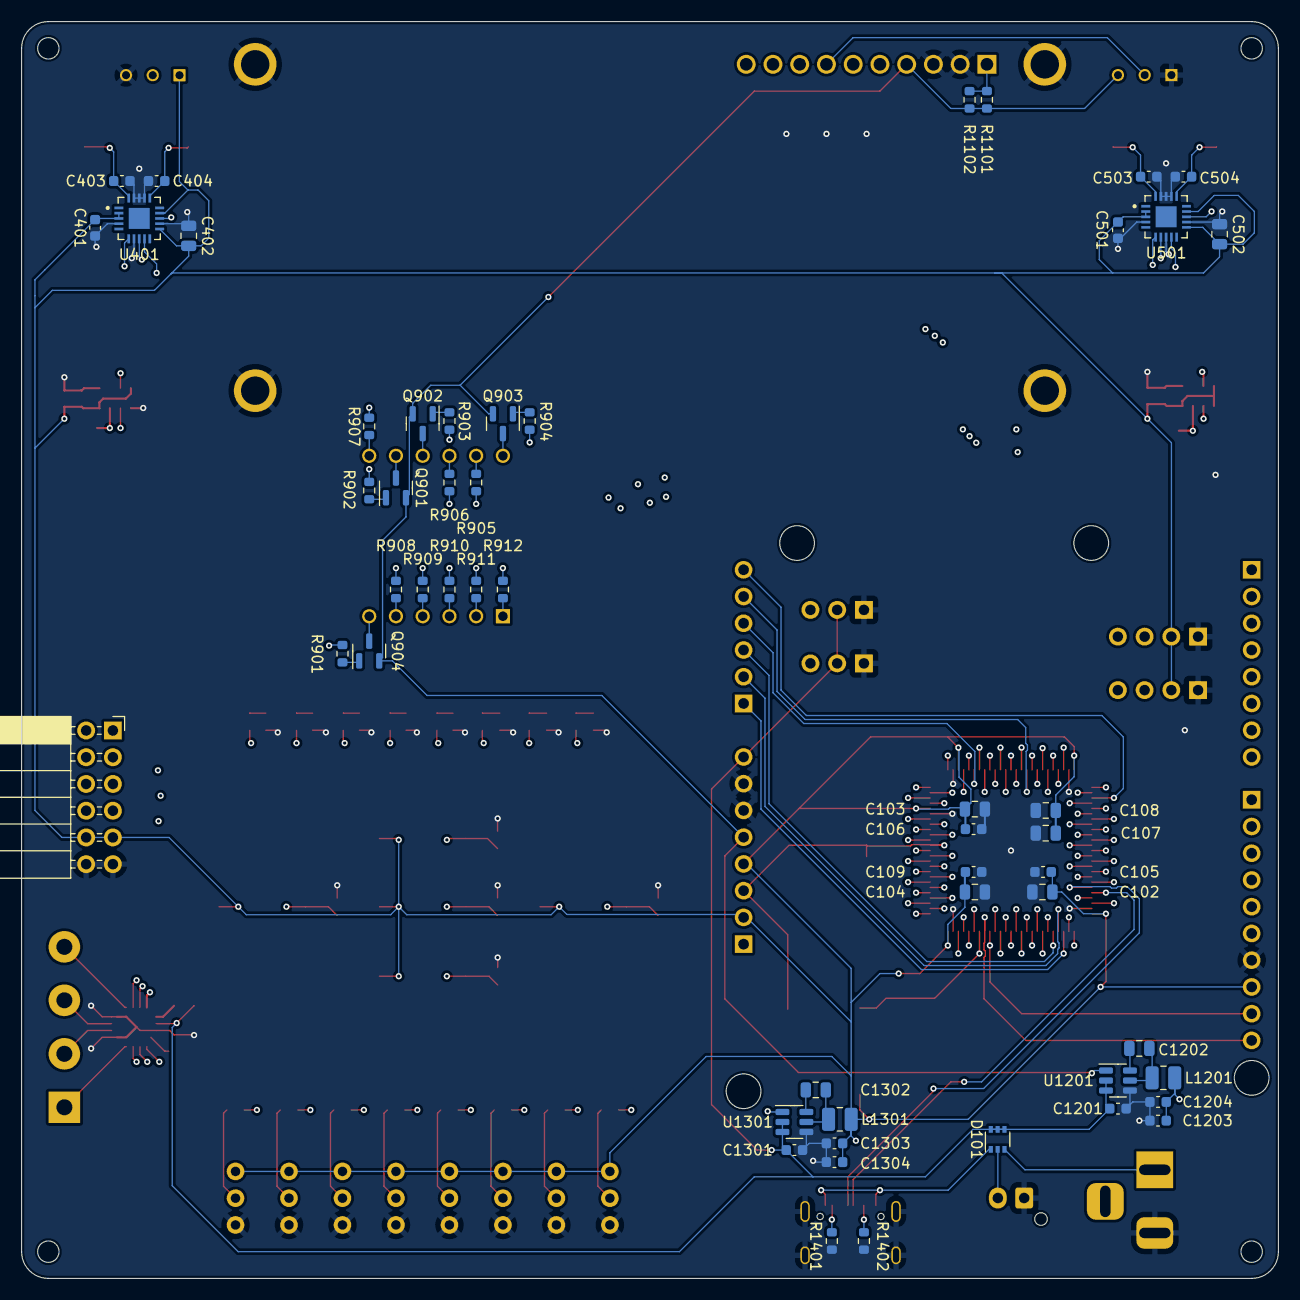
[picture p15: board UDuino.kicad_pcb from below]

Board: 4 copper layers, 119.4 x 119.4 mm, 126 parts (52 on the bottom side), 141 nets.

Other parts of the board:
C201: 10u; C_0603_1608Metric
C202: 10n; C_0603_1608Metric
C501: 4u7; C_0603_1608Metric
C502: 100n; C_0805_2012Metric
C503, C504: 1n; C_0603_1608Metric
LS501: Speaker; SPKR_AS01508MS-SC11-WP-R
MK201: CMM-4030D-261-I2S-TR; MIC_CMM-4030D-261-I2S-TR
R201: 100; R_0603_1608Metric
U501: NAU8315YG; QFN50P400X400X80-21N

Their connections:
+3V3: C201.1, C202.2, C501.2, C502.1, MK201.4 (CHIPEN), MK201.5 (L/R), MK201.8 (VDD), U501.2 (VDD), U501.3 (EN), U501.11 (VDD), U501.14 (VDD); also elsewhere on the board
/I2S1_CK: U501.6 (BCLK); also elsewhere on the board
/I2S1_SD: U501.9 (DACIN); also elsewhere on the board
/I2S1_WS: U501.7 (FSR); also elsewhere on the board
/I2S2_CK: MK201.6 (SCK); also elsewhere on the board
/I2S2_SD: MK201.7 (SD), R201.2; also elsewhere on the board
/I2S2_WS: MK201.3 (WS); also elsewhere on the board
/Speaker Left/GAIN: U501.13 (GAIN); also elsewhere on the board
GND: C201.2, C202.1, C501.1, C502.2, C503.1, C504.2, MK201.1 (GND), R201.1, U501.4 (GND), U501.8 (FSL), U501.12 (GND), U501.17 (GND), U501.18 (GND), U501.19 (GND); also elsewhere on the board
unnamed: C503.2, LS501.P (1), U501.20 (OUTP)
unnamed: C504.1, LS501.N (2), U501.16 (OUTN)
