duncmccl/ARMStrong/(commit log)

2022-11-01 Added ESP32-S3 files
    [ESP32-S3-WROOM-1-N8.sch]
2022-11-15 Changed project to use KiCAD
    [Audio.kicad_sch, ESP32-S3-WROOM-1-N8.sch, Motor.kicad_sch, Speaker.kicad_sch, UDuino.kicad_pcb, UDuino.kicad_sch, microphone.kicad_sch]
2022-11-15 Rough placement of Speakers on board
    [Speaker.kicad_sch, UDuino.kicad_pcb, UDuino.kicad_sch]
2022-11-15 Rough placement of the Motor controller
    [UDuino.kicad_pcb, UDuino.kicad_sch]
2022-11-16 Added Switches, Buttons, LEDs, 7Seg, LCD
    [7Seg.kicad_sch, Buttons.kicad_sch, LCD.kicad_sch, LEDS.kicad_sch, LEDs.kicad_sch, SSD.kicad_sch, Speaker.kicad_sch, UDuino.kicad_pcb]
2022-11-17 Update board design
    5v and 3v3 power blocks wired up.
    [UDuino.kicad_pcb, UDuino.kicad_sch, power_3v3.kicad_sch]
2022-12-01 Routing of some wires
    [UDuino.kicad_pcb, UDuino.kicad_sch, lcd.kicad_sch]
2023-02-10 First week after winter break. Changed Power circuit design to use different DC to DC converter Setting correct footprints for the components like resistors and capacitors.
    [7Seg.kicad_sch, IMU.kicad_sch, LEDs.kicad_sch, Motor.kicad_sch, Speaker.kicad_sch, UDuino.kicad_pcb, button.kicad_sch, lcd.kicad_sch]
2023-02-13 Weekend progress
    Things that remain:
    4 LEDs to Microcontroller
    7-Seg to Microcontroller
    LCD to Microcontroller
    Microphone and Speakers to Microcontroller
    Power circuitry
    USB-C connector
    Reset and Boot buttons
    [7Seg.kicad_sch, Motor.kicad_sch, UDuino.kicad_pcb, UDuino.kicad_sch, USB.kicad_sch, lcd.kicad_sch, microphone.kicad_sch, power.kicad_sch]
2023-02-16 Feb 12 2023 Week Work
    Remaining Things to accomplish
    Audio connect to Microcontroller
    7-Seg connect to Microcontroller
    PMOD connect to Microcontroller
    Misc Microcontroller items, like reset and boot buttons
    [UDuino.kicad_pcb, UDuino.kicad_sch]
2023-02-20 REVISION 0 DONE
    Done first revision of the UDUINO
    [UDuino.kicad_pcb, UDuino.kicad_sch, switches.kicad_sch]
2023-02-20 DRC checks done, GRBL files made
    [UDuino-B_Cu.gbl, UDuino-B_Mask.gbs, UDuino-B_Paste.gbp, UDuino-B_Silkscreen.gbo, UDuino-Edge_Cuts.gm1, UDuino-F_Cu.gtl, UDuino-F_Mask.gts, UDuino-F_Paste.gtp]
2023-02-20 Silk screen touch up
    [UDuino-B_Cu.gbl, UDuino-B_Mask.gbs, UDuino-B_Paste.gbp, UDuino-B_Silkscreen.gbo, UDuino-Edge_Cuts.gm1, UDuino-F_Cu.gtl, UDuino-F_Mask.gts, UDuino-F_Paste.gtp]
2023-02-20 Update BOM and POC files
    [7Seg.kicad_sch, Motor.kicad_sch, Speaker.kicad_sch, UDuino.csv, UDuino.kicad_sch, lcd.kicad_sch, microphone.kicad_sch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]
2023-02-22 Fixed BOM and Silkscreen things
    [UDUINO-BOM.xlsx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]
2023-02-22 Fixed mounting hole sizes
2023-04-15 Fixed 7seg display
    [7Seg.kicad_sch, UDuino.kicad_sch]
